rclabs-dev/sas-28/files/sas28-switch_circuit_v1.pdf

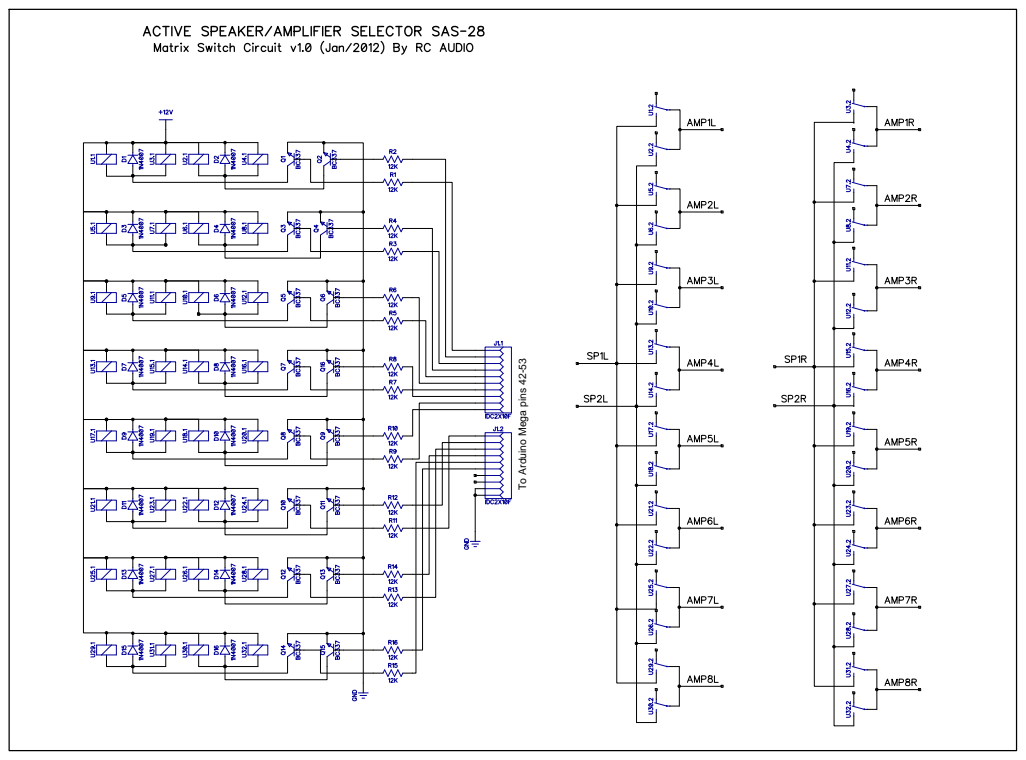
[picture p3: page 1]

To Arduino Mega pins 42-53
