rclabs-dev/sas-28/files/sas28_Control_Module.pdf

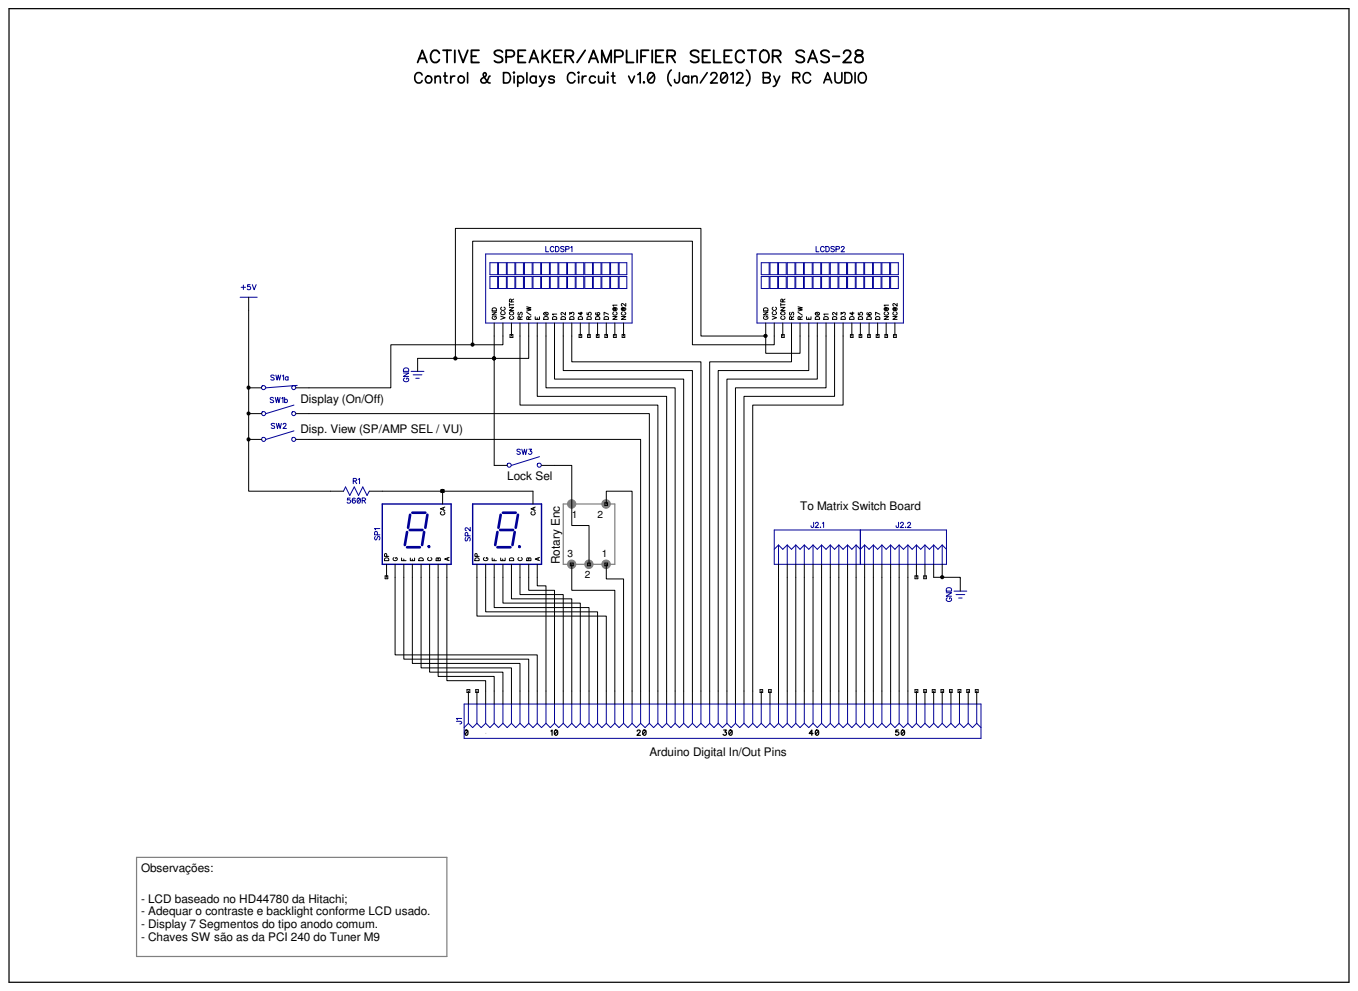
[picture p4: page 1]
Rotary Enc; Lock Sel; Observações:

Display (On/Off)

Disp. View (SP/AMP SEL / VU)

1 To Matrix Switch Board

Arduino Digital In/Out Pins

- LCD baseado no HD44780 da Hitachi;
- Adequar o contraste e backlight conforme LCD usado.
- Display 7 Segmentos do tipo anodo comum.
- Chaves SW são as da PCI 240 do Tuner M9
