rclabs-dev/sas-28/(list of files, drawings)

Other design files:
files/sas28-switch_circuit_v1.dch
files/sas28_Control_Module.dch
